wa1hco/Rotator_Controlller_Board/README.md

# Rotator_Controlller_Board
Board, Teensy, Relays for Ham M type rotators
