wa1hco/Rotator_Controlller_Board/Rotator Control Teensy 26VAC v2 BRD.pdf

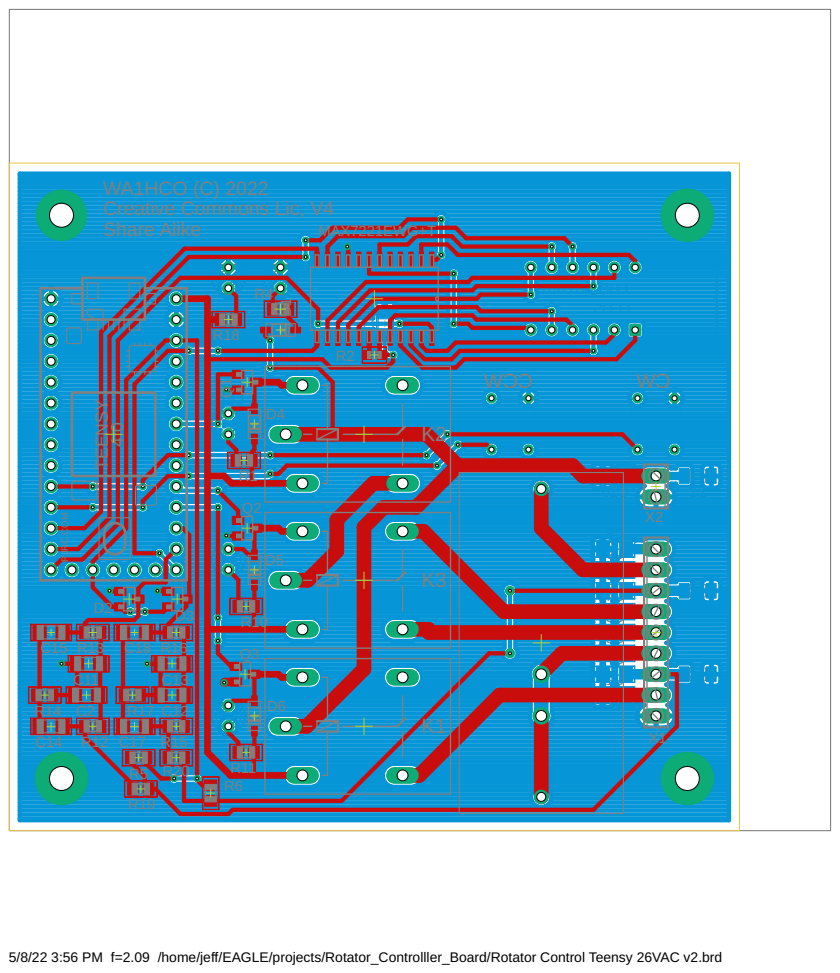
[picture p1: page 1]

R14 | C2 | R17 C12
C14 R12 C17 R15 | X1

R20
R5

R11
R6

5/8/22 3:56 PM f=2.09 /home/jeff/EAGLE/projects/Rotator_Controlller_Board/Rotator Control Teensy 26VAC v2.brd
