wa1hco/Rotator_Controlller_Board/Rotator Control Teensy 26VAC v2 SCH.pdf

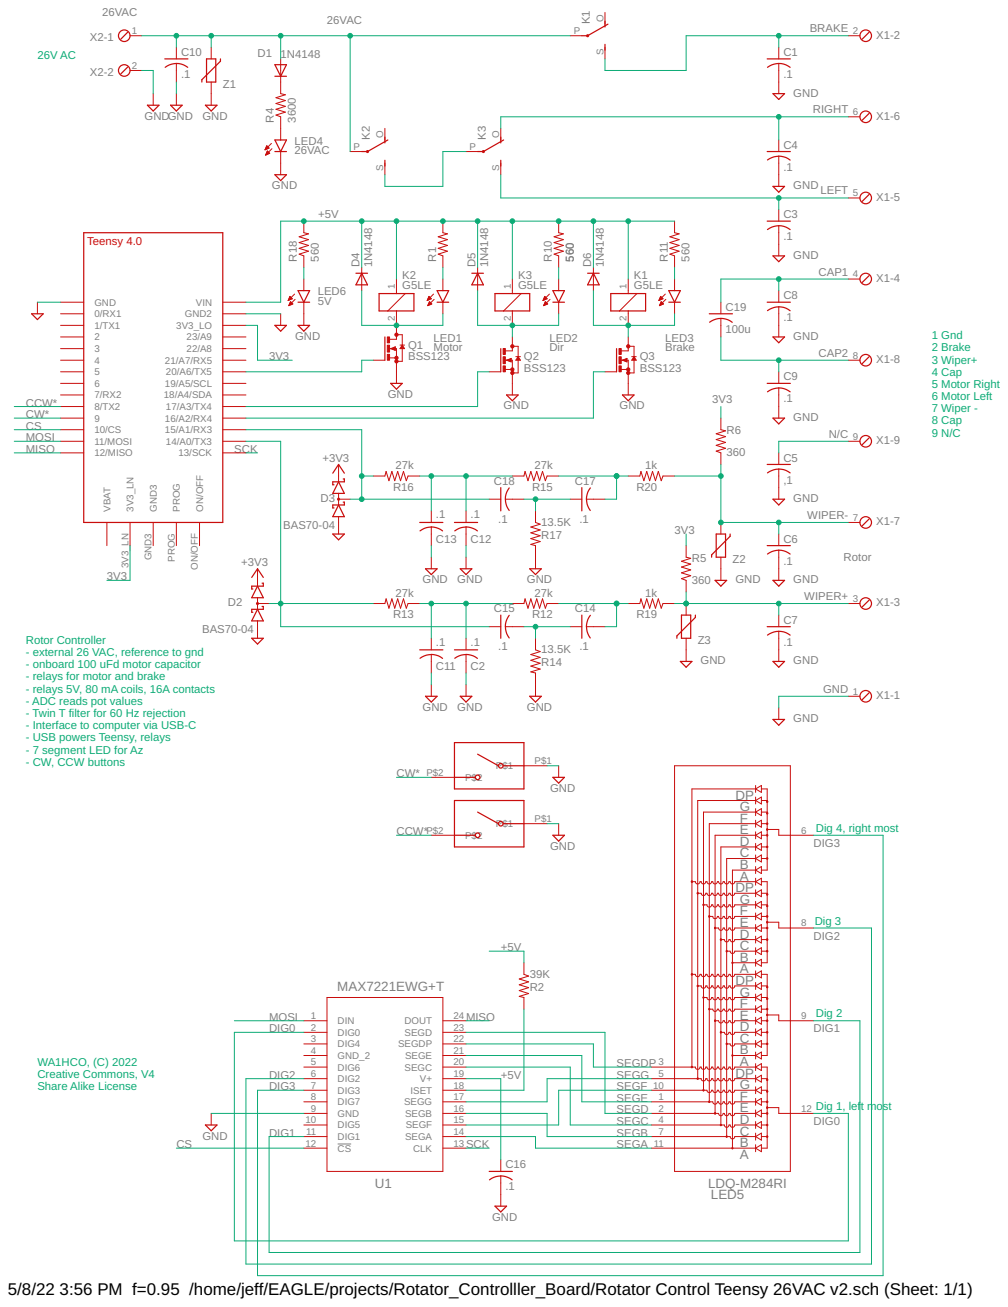
[picture p2: page 1]

1 Gnd
2 Brake
3 Wiper+
4 Cap
5 Motor Right 6 Motor Left 7 Wiper - 8 Cap

ON/OFF

Rotor Controller
- external 26 VAC, reference to gnd
- onboard 100 uFd motor capacitor
- relays for motor and brake
- relays 5V, 80 mA coils, 16A contacts
- ADC reads pot values
- Twin T filter for 60 Hz rejection
- Interface to computer via USB-C
- USB powers Teensy, relays
- 7 segment LED for Az
- CW, CCW buttons

5/8/22 3:56 PM f=0.95 /home/jeff/EAGLE/projects/Rotator_Controlller_Board/Rotator Control Teensy 26VAC v2.sch (Sheet: 1/1)
