wa1hco/Rotator_Controlller_Board/Rotator Control Teensy 26VAC v2.brd

## EAGLE design Rotator Control Teensy 26VAC v2.brd (2022-05-18)

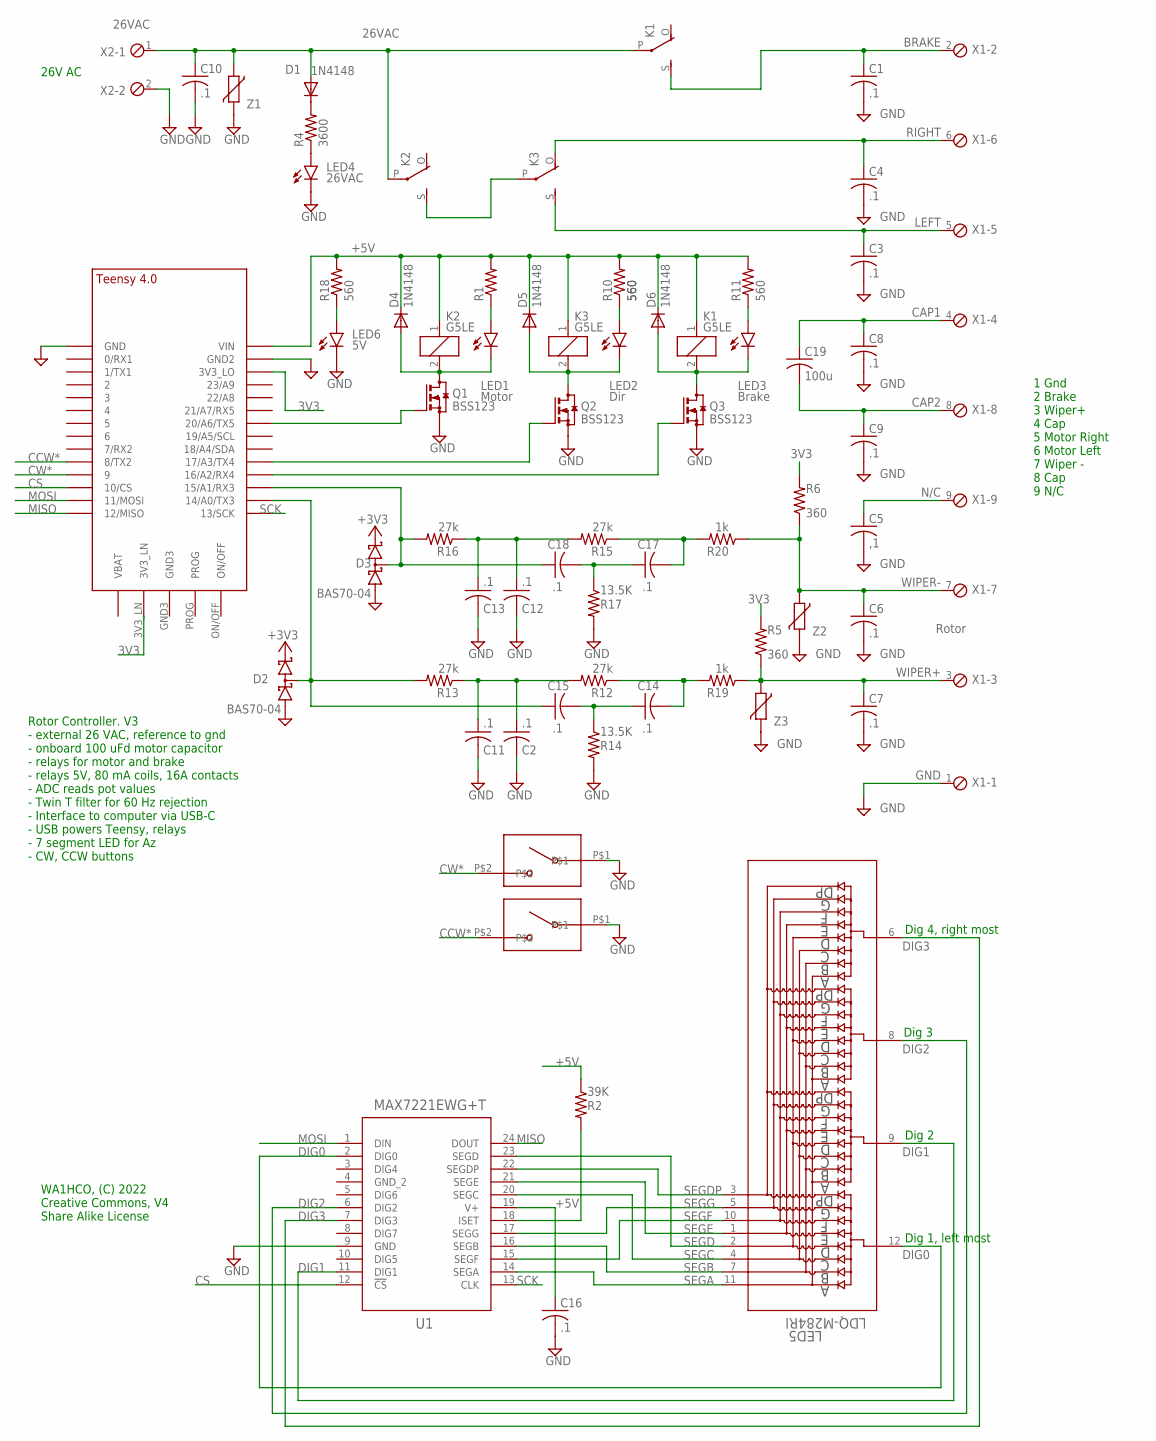
[picture p3: schematic Rotator Control Teensy 26VAC v2.sch]

Parts:
C1, C2, C3, C4, C6, C7, C8, C9, C10, C11, C12, C13, C14, C15, C16, C17, C18: .1; C1206
C5: ,1; C1206
C19: 100u; C4220
CCW: SWITCH_AEXIT_6X6X9.5; PUSHBUTTON_6X6
CW: SWITCH_AEXIT_6X6X9.5; PUSHBUTTON_6X6
D1, D4, D5, D6: 1N4148; SOD-123
D2, D3: BAS70-04; SOT23
K1, K2, K3: G5LE
LED1: Motor; LED3MM
LED2: Dir; LED3MM
LED3: Brake; LED3MM
LED4: 26VAC; LED3MM
LED5: LDQ-M284RI; LDQ-M284RI_LUM
LED6: 5V; LED3MM
Q1, Q2, Q3: BSS123; SOT23
R1, R10, R11, R18: 560; R0805
R2: 39K; R0603
R4: 3600; R0805
R5, R6: 360; R0805
R12, R13, R15, R16: 27k; R0805
R14, R17: 13.5K; R0805
R19, R20: 1k; R0805
U1: MAX7221EWG+T; 21-0042_W24+1_MXM
U$1: TEENSY_4.0
X1: Rotor; 9POL254
X2: 26VAC; 2POL254
Z1, Z2, Z3: VARISTORCN1206; CT/CN1206

Connections:
3V3: D2.2 (C2), D3.2 (C2), R5.2, R6.2, U$1.3V3_LN, U$1.3V3_LO
26VAC: C10.1, D1.A, K1.P, K2.P, X2.1, Z1.1
+5V: C16.1, D4.C, D5.C, D6.C, K1.1, K2.1, K3.1, R1.2, R2.1, R10.2, R11.2, R18.2, U1.19 (V+), U$1.VIN
BRAKE: C1.1, K1.S, X1.2
CAP1: C8.1, C19.P$1 (1), X1.4
CAP2: C9.1, C19.P$2 (2), X1.8
CCW*: CCW.P$2, U$1.8 (8/TX2)
CS: U1.12 (!CS), U$1.10/CS
CW*: CW.P$2, U$1.9/CS (9)
DIG0: LED5.12, U1.2 (DIG0)
DIG1: LED5.9, U1.11 (DIG1)
DIG2: LED5.8, U1.6 (DIG2)
DIG3: LED5.6, U1.7 (DIG3)
GND: C1.2, C2.2, C3.2, C4.2, C5.2, C6.2, C7.2, C8.2, C9.2, C10.2, C11.2, C12.2, C13.2, C16.2, CCW.P$1, CW.P$1, D2.1 (A1), D3.1 (A1), LED4.K (C), LED6.K (C), Q1.2 (S), Q2.2 (S), Q3.2 (S), R14.2, R17.2, U1.9 (GND), U$1.GND, U$1.GND2, X1.1, X2.2, Z1.2, Z2.2, Z3.2
ISET: R2.2, U1.18 (ISET)
LEFT: C4.1, K3.O, X1.6
MISO: U1.24 (DOUT), U$1.12/MISO
MOSI: U1.1 (DIN), U$1.11/MOSI
unnamed: C17.2, R15.1, R20.2
unnamed: LED6.A, R18.1
unnamed: C14.2, R12.1, R19.2
unnamed: LED1.A, R1.1
unnamed: LED2.A, R10.1
unnamed: LED3.A, R11.1
unnamed: C15.1, D2.3 (C1A2), R13.2, U$1.14/A0 (14/A0/TX3)
unnamed: K2.S, K3.P
unnamed: D4.A, K2.2, LED1.K (C), Q1.3 (D)
unnamed: D5.A, K3.2, LED2.K (C), Q2.3 (D)
unnamed: D6.A, K1.2, LED3.K (C), Q3.3 (D)
unnamed: Q3.1 (G), U$1.16/A2 (16/A2/RX4)
unnamed: Q1.1 (G), U$1.20/A6 (20/A6/TX5)
unnamed: Q2.1 (G), U$1.17/A3 (17/A3/TX4)
unnamed: C2.1, C11.1, R12.2, R13.1
unnamed: C14.1, C15.2, R14.1
unnamed: C12.1, C13.1, R15.2, R16.1
unnamed: C17.1, C18.2, R17.1
unnamed: C18.1, D3.3 (C1A2), R16.2, U$1.15/A1 (15/A1/RX3)
unnamed: D1.C, R4.2
unnamed: LED4.A, R4.1
N/C: C5.1, X1.9
RIGHT: C3.1, K3.S, X1.5
SCK: U1.13 (CLK), U$1.13/SCK
SEGA: LED5.11, U1.14 (SEGA)
SEGB: LED5.7, U1.16 (SEGB)
SEGC: LED5.4, U1.20 (SEGC)
SEGD: LED5.2, U1.23 (SEGD)
SEGDP: LED5.3, U1.22 (SEGDP)
SEGE: LED5.1, U1.21 (SEGE)
SEGF: LED5.10, U1.15 (SEGF)
SEGG: LED5.5, U1.17 (SEGG)
WIPER+: C7.1, R5.1, R19.1, X1.3, Z3.1
WIPER-: C6.1, R6.1, R20.1, X1.7, Z2.1

Notes on the sheet:
Rotor Controller. V3 - external 26 VAC, reference to gnd - onboard 100 uFd motor capacitor - relays for motor and brake - relays 5V, 80 mA coils, 16A contacts - ADC reads pot values - Twin T filter for 60 Hz rejection - Interface to computer via USB-C - USB powers Teensy, relays - 7 segment LED for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
1 Gnd 2 Brake 3 Wiper+ 4 Cap 5 Motor Right 6 Motor Left 7 Wiper - 8 Cap 9 N/C
26V AC
WA1HCO, (C) 2022 Creative Commons, V4 Share Alike License
Dig 4, right most
Dig 3
Dig 2
Dig 1, left most

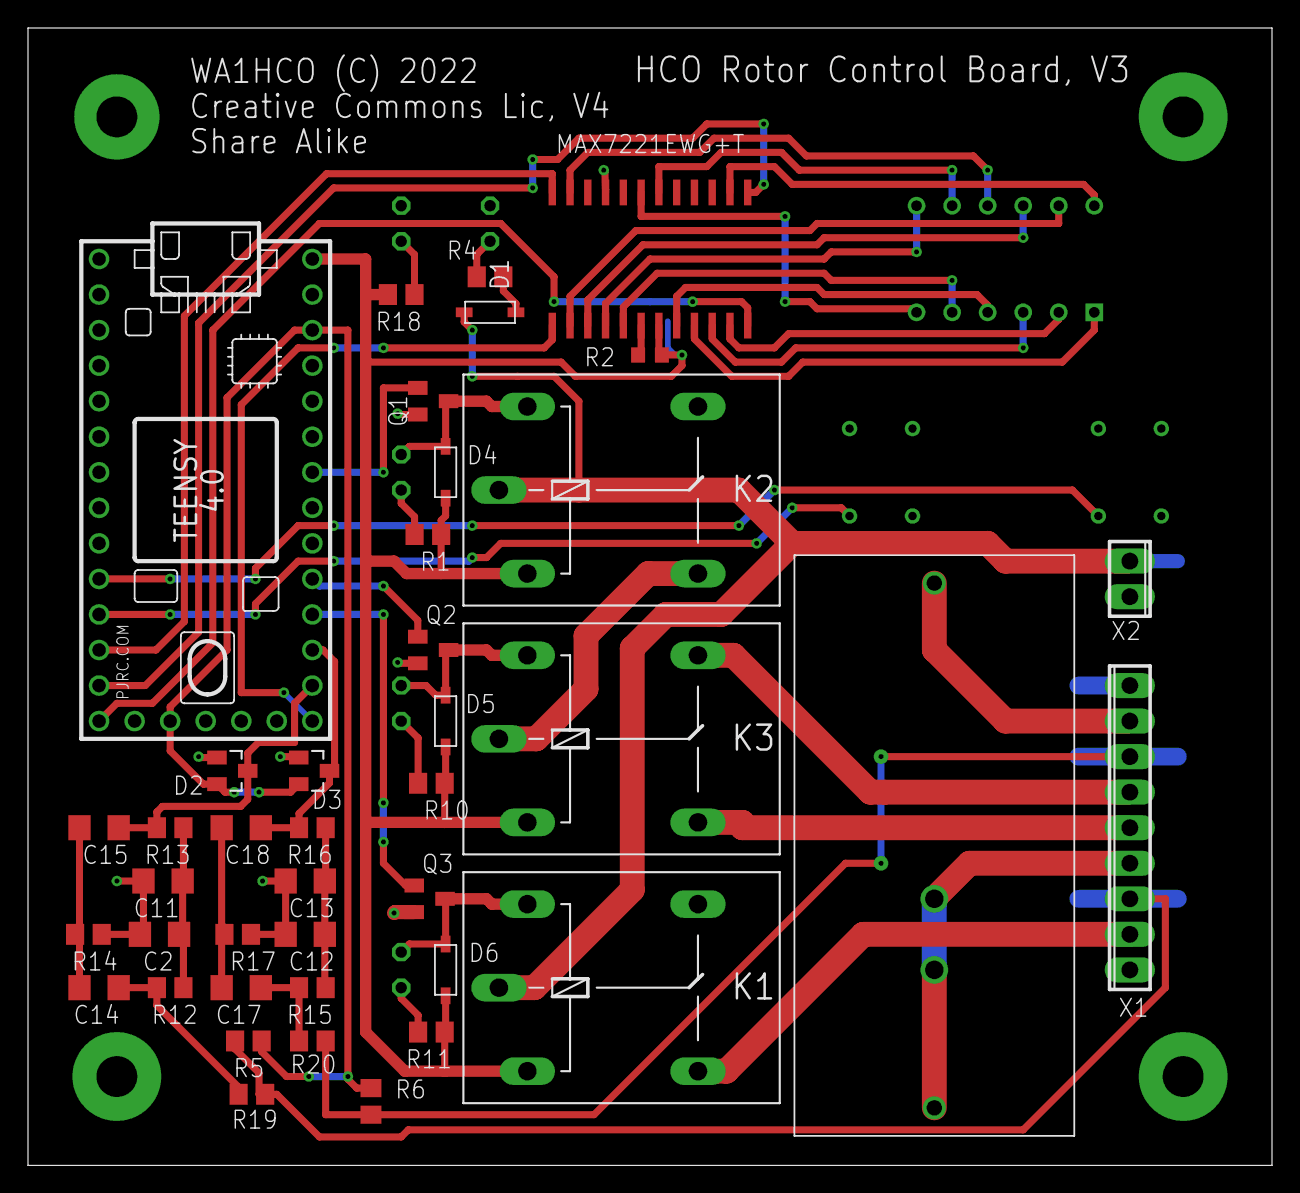
[picture p4: board Rotator Control Teensy 26VAC v2.brd from above]

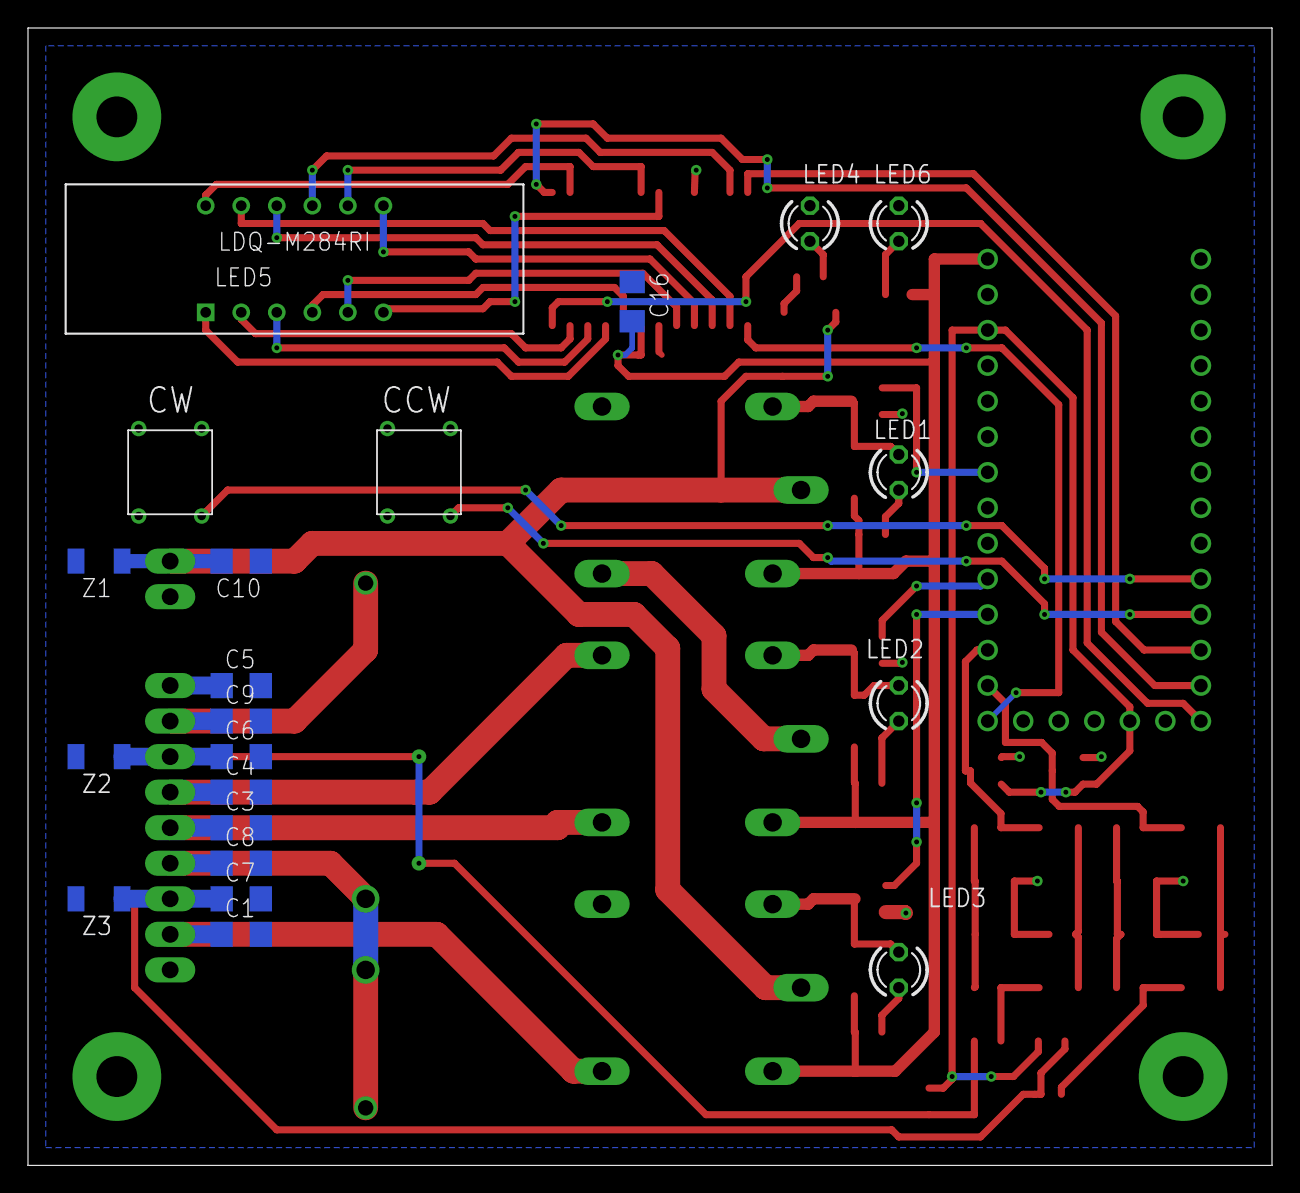
[picture p5: board Rotator Control Teensy 26VAC v2.brd from below]

Board: 2 copper layers, 88.9 x 81.3 mm, 62 parts (21 on the bottom side), 52 nets.
