wa1hco/Rotator_Controlller_Board/(commit log)

2022-03-11 Initial commit of Rotator Controller Board Teensy 4.0 processor, powered from USB C External 36 V AC transformer Relays for rotator interfacer 12V relays derived from 26V AC
    [Rotator Control Teensy 26VAC v2.brd, Rotator Control Teensy 26VAC v2.sch]
2022-03-12 add 5V LED, polishing
    [Rotator Control Teensy 26VAC v2.brd, Rotator Control Teensy 26VAC v2.sch]
2022-03-12 Simplified by running relays from 5V from USB 26V AC is only for the rotator
    [Rotator Control Teensy 26VAC v2.brd, Rotator Control Teensy 26VAC v2.sch]
2022-03-14 switched LED to -.28 inch 4 digit plus driver with keyswitch capability
    [Rotator Control Teensy 26VAC v2.brd, Rotator Control Teensy 26VAC v2.sch]
2022-03-15 Released this version to OshPark for fab
    [Rotator Control Teensy 26VAC v2.brd, Rotator Control Teensy 26VAC v2.sch]
2022-03-15 Add 5V power supply resistors to the rotor pot leads
    [Rotator Control Teensy 26VAC v2.brd, Rotator Control Teensy 26VAC v2.sch]
2022-04-01 Add pullups on I2C lines Add holes for 7 segment LED with 0.4 in lead spacing
    [Rotator Control Teensy 26VAC v2.brd, Rotator Control Teensy 26VAC v2.sch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]
2022-04-03 move rotator pot pullups from 5V to regulated 3.3V. 5V varied from USB to USB and changed when relays activated...which changed the azimuth calibration
    [Rotator Control Teensy 26VAC v2.brd, Rotator Control Teensy 26VAC v2.sch]
2022-04-12 Convert to MAX7221 LED driver Connect MAX7221 to SPI port Convert buttons to direct read with internal pullups
    [Rotator Control Teensy 26VAC v2.brd, Rotator Control Teensy 26VAC v2.sch]
2022-04-12 Version 2 sent to OSHPark Add pullup on ISET Tweaked a bunch of layout, unecessarily
    [Rotator Control Teensy 26VAC v2.brd, Rotator Control Teensy 26VAC v2.sch]
2022-05-07 Moved overvoltage protect diodes to after the 60 Hz notch filter. So the 60 Hz doesn't cause clipping and a DC shift when DC is near zero.
    Tweaked the layout accordingly.
    [Rotator Control Teensy 26VAC v2.brd, Rotator Control Teensy 26VAC v2.sch]
2022-05-18 Move OVP diodes close to ADC
    [Rotator Control Teensy 26VAC v2.brd, Rotator Control Teensy 26VAC v2.sch]
