wa1hco/Rotator_Controlller_Board/(notices)

Notices in the files:
Rotator Control Teensy 26VAC v2.brd:
Creative Commons Lic, V4
parts and their libraries:
COPYRIGHT: Copyright (C) 2022 Ultra Librarian. All rights reserved.
